oritomov/speedo/(list of files, drawings)

Other design files:
git/arduino/speedo.dsn
git/uaf2115.dsn
