oritomov/speedo/src/Arduino/speedo/speedo.ino

/*
  Main routine of speedometer for PIC16F648A
  version: 0.2

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
  You should have received a copy of the GNU General Public License
  along with this program.  If not, see <http://www.gnu.org/licenses/>.
*/

//#define SINGLE_DISPLAY
//#define VOLATILE

#include "button.h"
#include "common.h"
#include "display.h"
#include "fuel.h"
#include "hall.h"
#include "hodo.h"
#include "speed.h"
#include "tires.h"

#define HALL_PIN        2
#define LPG_INPUT       3
#define BUTTON_PIN      4

#define MSG_UNLEAD      "Unlead"
#define MSG_LPG         "LPG"
#define MSG_RESET       "Reset?"
#define MSG_TIRES       "Tires?"
#define MSG_WIDTH       "Width?"
#define MSG_WALL        "Wall?"
#define MSG_WHEEL       "Wheel?"
#define MSG_FIX         "Fix?"
#define MSG_NEXT        "Ok?"
#define MSG_ERROR       "ERROR!"

// The display unit's current task is defined by a state machine.  Normally on boot it defaults to MODE_SPD
// which displays the current speed as a normal speedometer.
// MSG_EEE is not a real mode, but it's here to prevent an overflow bug in sevenseg_text
typedef enum { MODE_EEE,
               MODE_UNL, MODE_LPG,
               MODE_SPD,
               MODE_MENU_CLR, MODE_CLR,
               MODE_TIRE,
               MODE_WIDTH, MODE_WALL, MODE_WHEEL, MODE_FIX,
               MODE_NEXT
             } mainmode;

#define MODE_DEFAULT  MODE_SPD

// ram
mainmode current_mode;        // tells our state machine which task the main loop is trying to execute
boolean flag_lpg_mode;        // use for unleaded or lpg mode.

void setup() {
  Serial.begin(9600);

#ifdef display_h
  bigDisplay.init();
#ifndef SINGLE_DISPLAY
  smallDisplay.init();
#endif //SINGLE_DISPLAY
#endif //display_h

  noInterrupts();             // disable all interrupts
#ifdef button_h
  button.init();              // tmr0 & D3
#endif //button_h
#ifdef fuel_h
  fuel.init();                // D4
#endif //fuel_h
  hall.init();                // tmr1 & D2
#ifdef hodo_h
  hodo.init();
#endif //hodo_h
  speed.init();
  interrupts();               // enable interrupts

  current_mode = MODE_DEFAULT;
  flag_lpg_mode = fuel.flag_lpg_reed;
  hodo.read_trip(flag_lpg_mode);
}

#ifdef button_h
int read_tire(int eeprom, int _default, int step, int min) {
  int tire;
  tire = eeprom_read(eeprom);
  if (tire == 0xFF) {
    tire = _default;
  } else {
    tire *= step;
    tire += min;
  }
  return tire;
}

void calc_tire(void) {
  int width = read_tire(EEPROM_WIDTH, WIDTH_DEFAULT, WIDTH_STEP, WIDTH_MIN);
  int wall = read_tire(EEPROM_WALL, WALL_DEFAULT, WALL_STEP, WALL_MIN);
  int wheel = read_tire(EEPROM_WHEEL, WHEEL_DEFAULT, WHEEL_STEP, WHEEL_MIN);
  int fix = read_tire(EEPROM_FIX, FIX_DEFAULT, FIX_STEP, FIX_MIN);

  // (14" * 2.54cm * 0.01 m/cm + 2 * 195mm * 0.001 m/mm * 60%) * pi => 1.85m
  // 100m / 1.85m * 8 pulses/turn = 54 turns/100m * 8 pulses/turn = 432 pulses / 100m
  uint16_t pulses_in_100m = (int)(8. * 100. * (1. + (float)fix / 100.) / (((float)wheel * 2.54 * 0.01 + 2. * (float)width * 0.001 * ((float)wall / 100.)) * 3.14));
  Serial.print("pulses in 100m = ");
  Serial.println(pulses_in_100m);
  eeprom_pulses_in_100m(pulses_in_100m);
#ifdef hodo_h
  hodo.init();
#endif //hodo_h
  // 3600 sec/h * 1000000 us/sec * 0.1 km / 32 = 11250000 us * 100m / h
  // 11250000 / 432 pulses_in_100m = 26041.67
  uint16_t calib_factor = 11250000 / pulses_in_100m;
  Serial.print("calib_factor = ");
  Serial.println(calib_factor);
  eeprom_calib_factor(calib_factor);
  speed.init();
}

void set_mode_and_reset_button(mainmode mode) {
  switch (mode) {
    case MODE_SPD:  // calculate and show current speed until a button is held
      Serial.println("Speed");
      break;
    case MODE_UNL:     // show mode
      Serial.println(MSG_UNLEAD);
      break;
    case MODE_LPG:
      Serial.println(MSG_LPG);
      break;
    case MODE_MENU_CLR:   // show menu
      Serial.println(MSG_RESET);
      break;
    case MODE_CLR:      // clear trip
      break;
    case MODE_TIRE:   // show menu
      Serial.println(MSG_TIRES);
      break;
    case MODE_WIDTH:   // show menu
      Serial.println(MSG_WIDTH);
      break;
    case MODE_WALL:   // show menu
      Serial.println(MSG_WALL);
      break;
    case MODE_WHEEL:   // show menu
      Serial.println(MSG_WHEEL);
      break;
    case MODE_FIX:   // show menu
      Serial.println(MSG_FIX);
      break;
    case MODE_NEXT:   // show menu
      Serial.println(MSG_NEXT);

  }
  current_mode = mode;
  button.reset();
}
#endif //button_h

void loop() {
#ifdef button_h
  static int current, min, max, step, eeprom;
//  boolean lpg;

  // force setup
  if (current_mode != MODE_NEXT) {
    if (eeprom_read(EEPROM_WIDTH) == 0xFF) {
      set_mode_and_reset_button(MODE_WIDTH);
    } else if (eeprom_read(EEPROM_WALL) == 0xFF) {
      set_mode_and_reset_button(MODE_WALL);
    } else if (eeprom_read(EEPROM_WHEEL) == 0xFF) {
      set_mode_and_reset_button(MODE_WHEEL);
    } else if (eeprom_read(EEPROM_FIX) == 0xFF) {
      set_mode_and_reset_button(MODE_FIX);
    }
  }

#ifdef fuel_h
//  lpg = fuel.flag_lpg_reed;
  if (fuel.flag_lpg_reed != flag_lpg_mode) {
    if (fuel.flag_lpg_reed) {
      set_mode_and_reset_button(MODE_LPG);
    } else {
      set_mode_and_reset_button(MODE_UNL);
    }
    flag_lpg_mode = fuel.flag_lpg_reed;
#ifdef hodo_h
    hodo.read_trip(flag_lpg_mode);
#endif //hodo_h
  }
#endif //fuel_h

  switch (current_mode) {

    case MODE_SPD:  // calculate and show current speed until a button is held
#endif //button_h

      //      Serial.println("Speed");
#ifdef speed_h
      speed.calculate(0);
#endif //speed_h
#ifdef hodo_h
      hodo.write_distance();
#endif //hodo_h
#ifdef display_h
      bigDisplay.speed(speed.speed);
#ifndef SINGLE_DISPLAY
      smallDisplay.trip(hodo.trip);
#endif //SINGLE_DISPLAY
#endif //display_h
#ifdef button_h
      //display.distance(hodo.distance);
      if (button.status == BUTTON_STATUS_PRESSED) {
        set_mode_and_reset_button(MODE_MENU_CLR);
      }
      break;

    case MODE_UNL:     // show mode
    case MODE_LPG:
      if (current_mode == MODE_UNL) {
#ifdef display_h
        bigDisplay.mode(MSG_UNLEAD);
#endif //display_h
        //        Serial.println(MSG_UNLEAD);
      } else {
#ifdef display_h
        bigDisplay.mode(MSG_LPG);
#endif //display_h
        //        Serial.println(MSG_LPG);
      }
#ifdef display_h
#ifndef SINGLE_DISPLAY
      smallDisplay.trip(hodo.trip);
#endif //SINGLE_DISPLAY
#endif //display_h
      switch (button.status) {
        //calculate_speed(0);
        //write_distance();
        //display_trip(trip);
        //display_distance(distance);
        case BUTTON_STATUS_PRESSED:
        case BUTTON_STATUS_HELD:
        case BUTTON_STATUS_TIMEOUT:
          set_mode_and_reset_button(MODE_DEFAULT);
          break;
      }
      break;

    case MODE_MENU_CLR:   // show menu
      //      Serial.println(MSG_RESET);
#ifdef display_h
#ifdef SINGLE_DISPLAY
#ifdef hodo_h
      bigDisplay.mode(MSG_RESET, hodo.trip);
#endif // hodo_h
#else //SINGLE_DISPLAY
      bigDisplay.mode(MSG_RESET);
      smallDisplay.trip(hodo.trip);
#endif //SINGLE_DISPLAY
#endif //display_h
      switch (button.status) {
        case BUTTON_STATUS_PRESSED:
          set_mode_and_reset_button(MODE_TIRE);
          break;
        case BUTTON_STATUS_HELD:
          set_mode_and_reset_button(MODE_CLR);
          break;
        case BUTTON_STATUS_TIMEOUT:
          set_mode_and_reset_button(MODE_DEFAULT);
          break;
      }
      break;

    case MODE_CLR:      // clear trip
      //Serial.println("Reseting");
#ifdef hodo_h
      hodo.reset();
#endif //hodo_h
      //display_trip(trip);
      set_mode_and_reset_button(MODE_SPD);
      break;

    case MODE_TIRE:   // show menu
      //      Serial.println(MSG_TIRES);
#ifdef display_h
      bigDisplay.mode(MSG_TIRES);
#endif //display_h
      switch (button.status) {
        case BUTTON_STATUS_PRESSED:
          set_mode_and_reset_button(MODE_DEFAULT);    // let's wrap around.
          break;
        case BUTTON_STATUS_HELD:
          set_mode_and_reset_button(MODE_WIDTH);
          break;
        case BUTTON_STATUS_TIMEOUT:
          set_mode_and_reset_button(MODE_DEFAULT);
          break;
      }
      break;

    case MODE_WIDTH:   // show menu
      current = read_tire(EEPROM_WIDTH, WIDTH_DEFAULT, WIDTH_STEP, WIDTH_MIN);
#ifdef display_h
#ifdef SINGLE_DISPLAY
      bigDisplay.mode(MSG_WIDTH, current);
#else //SINGLE_DISPLAY
      bigDisplay.mode(MSG_WIDTH);
      smallDisplay.num(current);
#endif //SINGLE_DISPLAY
#endif //display_h
      //      Serial.print(current);
      //      Serial.println(MSG_WIDTH);
      switch (button.status) {
        case BUTTON_STATUS_PRESSED:
          set_mode_and_reset_button(MODE_WALL);
          break;
        case BUTTON_STATUS_HELD:
          min = WIDTH_MIN;
          max = WIDTH_MAX;
          step = WIDTH_STEP;
          eeprom = EEPROM_WIDTH;
          set_mode_and_reset_button(MODE_NEXT);
          break;
        case BUTTON_STATUS_TIMEOUT:
          set_mode_and_reset_button(MODE_DEFAULT);
          break;
      }
      break;

    case MODE_WALL:   // show menu
      current = read_tire(EEPROM_WALL, WALL_DEFAULT, WALL_STEP, WALL_MIN);
#ifdef display_h
#ifdef SINGLE_DISPLAY
      bigDisplay.mode(MSG_WALL, current);
#else //SINGLE_DISPLAY
      bigDisplay.mode(MSG_WALL);
      smallDisplay.num(current);
#endif //SINGLE_DISPLAY
#endif //display_h
      //Serial.print(current);
      //Serial.println(MSG_WALL);
      switch (button.status) {
        case BUTTON_STATUS_PRESSED:
          set_mode_and_reset_button(MODE_WHEEL);
          break;
        case BUTTON_STATUS_HELD:
          min = WALL_MIN;
          max = WALL_MAX;
          step = WALL_STEP;
          eeprom = EEPROM_WALL;
          set_mode_and_reset_button(MODE_NEXT);
          break;
        case BUTTON_STATUS_TIMEOUT:
          set_mode_and_reset_button(MODE_DEFAULT);
          break;
      }
      break;

    case MODE_WHEEL:   // show menu
      current = read_tire(EEPROM_WHEEL, WHEEL_DEFAULT, WHEEL_STEP, WHEEL_MIN);
#ifdef display_h
#ifdef SINGLE_DISPLAY
      bigDisplay.mode(MSG_WHEEL, current);
#else //SINGLE_DISPLAY
      bigDisplay.mode(MSG_WHEEL);
      smallDisplay.num(current);
#endif //SINGLE_DISPLAY
#endif //display_h
      //Serial.print(current);
      //Serial.println(MSG_WHEEL);
      switch (button.status) {
        case BUTTON_STATUS_PRESSED:
          set_mode_and_reset_button(MODE_FIX);
          break;
        case BUTTON_STATUS_HELD:
          min = WHEEL_MIN;
          max = WHEEL_MAX;
          step = WHEEL_STEP;
          eeprom = EEPROM_WHEEL;
          set_mode_and_reset_button(MODE_NEXT);
          break;
        case BUTTON_STATUS_TIMEOUT:
          set_mode_and_reset_button(MODE_DEFAULT);
          break;
      }
      break;

    case MODE_FIX:   // show menu
      current = read_tire(EEPROM_FIX, FIX_DEFAULT, FIX_STEP, FIX_MIN);
#ifdef display_h
#ifdef SINGLE_DISPLAY
      bigDisplay.mode(MSG_FIX, current);
#else //SINGLE_DISPLAY
      bigDisplay.mode(MSG_FIX);
      smallDisplay.num(current);
#endif //SINGLE_DISPLAY
#endif //display_h
      //Serial.print(current);
      //Serial.println(MSG_FIX);
      switch (button.status) {
        case BUTTON_STATUS_PRESSED:
          set_mode_and_reset_button(MODE_DEFAULT);    // let's wrap around.
          break;
        case BUTTON_STATUS_HELD:
          min = FIX_MIN;
          max = FIX_MAX;
          step = FIX_STEP;
          eeprom = EEPROM_FIX;
          set_mode_and_reset_button(MODE_NEXT);
          break;
        case BUTTON_STATUS_TIMEOUT:
          set_mode_and_reset_button(MODE_DEFAULT);
          break;
      }
      break;

    case MODE_NEXT:   // show menu
#ifdef display_h
#ifdef SINGLE_DISPLAY
      bigDisplay.mode(MSG_NEXT, current);
#else //SINGLE_DISPLAY
      bigDisplay.mode(MSG_NEXT);
      smallDisplay.num(current);
#endif //SINGLE_DISPLAY
#endif //display_h
      //Serial.print(current);
      //Serial.println(MSG_NEXT);
      switch (button.status) {
        case BUTTON_STATUS_PRESSED:
          current += step;
          if (current > max) {
            current = min;
          }
          set_mode_and_reset_button(MODE_NEXT);
          break;
        case BUTTON_STATUS_HELD:
          current -= min;
          current /= step;
          eeprom_write(eeprom, (uint8_t)current);
          calc_tire();
          set_mode_and_reset_button(MODE_DEFAULT);
          break;
        case BUTTON_STATUS_TIMEOUT:
          set_mode_and_reset_button(MODE_DEFAULT);
          break;
      }
      break;

    default:
#ifdef display_h
      bigDisplay.mode(MSG_ERROR);
#endif //display_h
      Serial.println(MSG_ERROR);
      // We should never arrive here.
      // if we're debugging, we want to know about this; print MSG_EEE and lockup.
      while (button.status == BUTTON_STATUS_NONE) {
      }
      // if we're not debugging, just get us back into MODE_DEFAULT.
      set_mode_and_reset_button(MODE_DEFAULT);
      break;
  }
#endif //button_h
}
