oritomov/speedo/src/Arduino/speedo/tires.h

#ifndef tires_h
#define tires_h

#define EEPROM_WIDTH 11
#define WIDTH_DEFAULT 185
#define WIDTH_MIN 135
#define WIDTH_MAX 315
#define WIDTH_STEP 5

#define EEPROM_WALL 12
#define WALL_DEFAULT 55
#define WALL_MIN 30
#define WALL_MAX 80
#define WALL_STEP 5

#define EEPROM_WHEEL 13
#define WHEEL_DEFAULT 15
#define WHEEL_MIN 12
#define WHEEL_MAX 22
#define WHEEL_STEP 1

#define EEPROM_FIX 14
#define FIX_DEFAULT 0
#define FIX_MIN -10
#define FIX_MAX 10
#define FIX_STEP 1

#endif //tires_h
