oritomov/speedo/src/Arduino/speedo/button.ino

/*
Button subroutine.
version: 0.2

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
  You should have received a copy of the GNU General Public License
  along with this program.  If not, see <http://www.gnu.org/licenses/>.
*/

#ifdef button_h

#ifndef BUTTON_DELAY
#define BUTTON_DELAY  5000
#endif //BUTTON_DELAY

#ifndef BUTTON_HELD
#define BUTTON_HELD   400
#endif //BUTTON_HELD

// Interrupt is called once in a millisecond 
ISR(TIMER0_COMPA_vect) {
  button.interrupt();
}

void Button::init() {
  pinMode(BUTTON_PIN, INPUT_PULLUP);
  held_count = 0;
  reset();
  
  TIMSK0 |= (1 << OCIE0A);              // enable timer0 compare interrupt
}

void Button::reset(void) {
  rlsd_count = 0;
  status = BUTTON_STATUS_NONE;
}

// button polling routine (every 1 ms)
void Button::interrupt(void) {

  // the flags will be cleared externally
  boolean input = digitalRead(BUTTON_PIN);

  // the flags will be cleared externally
  if (!input) { // if button is pressed, BUTTON_PIN is held low.
    held_count++;
    // if the button has been on 400 times in a row (about half a second), flag it as being held
    if (held_count == BUTTON_HELD) {
      status = BUTTON_STATUS_HELD;
      Serial.println("button held");
    } else if (held_count == BUTTON_DELAY) {
      // if the button has been on more than 400 times in a row, we've already flagged it as held
      held_count--; // so as not to overflow
    }

    rlsd_count = 0;
  } else {
    // if the button hasn't been pressed, nothing to report.
    // if the button was released after being on once or twice, it was a glitch.
    // if the button was released after being on between 2 and 399 times in a row, it was pressed
    if ((held_count > 1) && (held_count < BUTTON_HELD)) {
      status = BUTTON_STATUS_PRESSED;
      Serial.println("button pressed");
    }
    // if the button was released after being on more than that, we already flagged it as held.
    held_count = 0;

    rlsd_count++;
    if (rlsd_count == BUTTON_DELAY) {
      status = BUTTON_STATUS_TIMEOUT;
      Serial.println("button time out");
    } else if (rlsd_count > BUTTON_DELAY) {
      rlsd_count--; // so as not to overflow
    }
  }
}
#endif
