oritomov/speedo/(commit log)

2011-10-19 initial button, display, leds & test routines
2011-10-19 add main speedo, fix storing of half distance
    [hodo.c, hodo.h, leds.c, leds.h, speed.c, speed.h, speedo.c, test.c]
2011-10-20 fix display lpg mode
    [hodo.c, hodo.h, speedo.c]
2011-10-22 fix init test, check display & move pragma defs to common
    [common.h, display.c, speedo.c, test.c]
2011-10-22 fix pragma defs to test
    [common.h, test.c]
2011-10-22 fix asynchronous reading of sevenseg_bits
    [display.c, display.h, leds.c]
2011-11-01 add some timer comments
2011-12-06 winter tyres
2011-12-11 fix hodo leds
2011-12-16 fix winter tyres
2017-05-01 arduino src
2017-05-08 button interrupt
2017-08-27 bug fix - typo
    [speedo.ino]
2017-08-27 fix calib_factor via DIVIDER
    [speed.h, speed.ino, speedo.ino]
2017-09-09 button status
2017-09-10 button timer interrupt
2017-09-10 fix print mode; lpg & unlead
    [speedo.ino]
2018-04-14 fix etc
    [speedo.dsn, uaf2115.dsn]
2018-04-14 fix pcb
2018-05-01 fix display connectors/order
2018-05-01 Revert "fix path"
    This reverts commit 110f795b8cc9854fdce6136633d0dc3aa8db3bab.
    [hall.h, hall.ino]
2018-05-01 Revert "fix path"
    This reverts commit 8f6ff171ba7e9c227ffcadc5b9cbc553a47d1486.
    [hall.ino]
2018-05-01 Revert "fix path"
    This reverts commit 5168bf511847704a46813637846b97fa5b6c0b25.
    [hall.h]
2018-05-01 Revert "fix path"
    This reverts commit 3c4cc0975381c2691382c04b3a40a9b4c61591c9.
    [common.ino]
2018-05-01 Revert "fix path"
    This reverts commit 6ff7c516e990dc7fb203d2da0e0e3cc204177f1c.
    [common.h]
2018-05-01 Revert "Revert "fix path""
    This reverts commit 61c5742e2c5d357d0d12973e4f0a4f4648e8391f.
    [common.ino]
2018-05-01 Revert "Revert "fix path""
    This reverts commit 43ca2b0eefd24599b741fd24c7776d8ed0d0595b.
    [hall.h]
2018-05-01 Revert "Revert "fix path""
    This reverts commit 2f1865ec1532a832b96604e68c7c7dc9f8de6b1d.
    [hall.ino]
2018-05-01 Revert "Revert "fix path""
    This reverts commit 8549b4c57e06f02384c2d03c28f5d9b806afb7cd.
    [common.h]
2018-05-05 fix main pcb
